mustafayaqoobi78/communication-systems-project/(commit log)

2026-04-27 feat: initial publish — AM-USB and BPSK with TDM transceivers
2026-06-04 feat(am-usb): add MATLAB DSP verification section and script
    Inserts §1.3 DSP Model Verification before the SIMetrix section, with
    four new figures (waveforms, spectrum, recovery, phase experiment) and
    the am_ssb_phase_shift.m source. Renumbers subsequent sections
    1.3→1.4 through 1.6→1.7 and updates internal cross-references.
    Octave verification reproduces the 263 dB ideal-suppression result and
    amplitude preservation across 0°/90°/180° LO phase.
2026-06-04 feat(bpsk): add MATLAB DSP verification section and script
    Inserts §2.3 DSP Model Verification before the SIMetrix section, with
    §2.3.1–2.3.5 and five figures (TDM construction, BPSK modulated, spectrum,
    recovery, phase experiment) and the bpsk_tdm.m source. Renumbers
    downstream sections 2.3→2.4 through 2.8→2.9 (including all subsections).
    Octave verification reproduces BER = 0/20 and the cos(phi) phase
    behaviour: 0.502 V at 0° and 180°, ~0 V at 90°.
2026-06-04 feat: add SIMetrix source files for AM-USSB and BPSK
    Moves the SIMetrix schematic and SPICE netlists into the repo under a
    new simetrix/ folder so the circuits are openable and reproducible
    alongside the docs and figures, not just visible as screenshots.
    simetrix/am_usb/AM_USSB.sxsch SIMetrix schematic
    simetrix/am_usb/AM_USSB_circuit.cir SPICE netlist
    simetrix/bpsk/bpsk_behavioural.cir SPICE netlist
    Updates the README repo-layout block accordingly.
2026-06-04 fix(readme): use └── for simetrix/ as the last layout entry
    Corrects the tree-art so the final top-level entry uses the
    terminal connector and its children no longer carry the trailing
    vertical bar.
